iannight10412/Joint-ego-noise-reduction-source-localization-and-beamforming-for-rescue-vehicles/(list of files, cad)

Other CAD files:
models/HC-SR04 Ultrasonic Sensor Holder.ipt
models/Respeaker-holder.ipt
models/Shell-disc.ipt
