iannight10412/Joint-ego-noise-reduction-source-localization-and-beamforming-for-rescue-vehicles/docs/大學專題海報.pdf

題目

學生： | 指導教授：

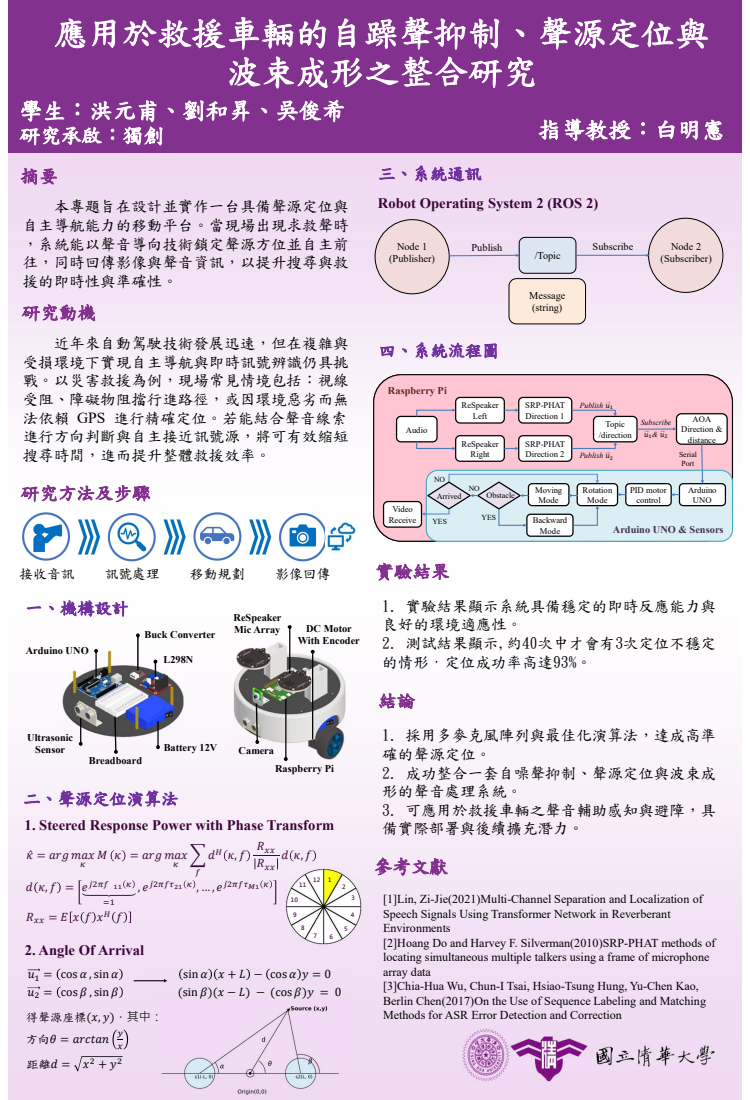
[picture p9: page 1]
研究動機; 研究方法及步驟; 實驗結果; 參考文獻; 指導教授：白明憲; 應用於救援車輛的自躁聲抑制、聲源定位與 波束成形之整合研究; 本專題旨在設計並實作一台具備聲源定位與 自主導航能力的移動平台。當現場出現求救聲時 ，系統能以聲音導向技術鎖定聲源方位並自主前 往，同時回傳影像與聲音資訊，以提升搜尋與救 援的即時性與準確性。; 一、機構設計; 四、系統流程圖; 1. 實驗結果顯示系統具備穩定的即時反應能力與 良好的環境適應性。 2. 測試結果顯示,約40次中才會有3次定位不穩定 的情形，定位成功率高達93%。; 1. 採用多麥克風陣列與最佳化演算法，達成高準 確的聲源定位。 2. 成功整合一套自噪聲抑制、聲源定位與波束成 形的聲音處理系統。 3. 可應用於救援車輛之聲音輔助感知與避障，具 備實際部署與後續擴充潛力。; Audio; ReSpeaker Left; Topic /direction; AOA Direction & distance ReSpeaker Right; SRP-PHAT Direction 1; SRP-PHAT Direction 2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

學生：洪元甫、劉和昇、吳俊希
研究承啟：獨創

三、系統通訊
Robot Operating System 2 (ROS 2)

近年來自動駕駛技術發展迅速，但在複雜與
受損環境下實現自主導航與即時訊號辨識仍具挑
戰。以災害救援為例，現場常見情境包括：視線
受阻、障礙物阻擋行進路徑，或因環境惡劣而無
法依賴 GPS 進行精確定位。若能結合聲音線索
進行方向判斷與自主接近訊號源，將可有效縮短
搜尋時間，進而提升整體救援效率。

Port PID motor

Arduino UNO & Sensors

二、聲源定位演算法
1. Steered Response Power with Phase Transform

Speech Signals Using Transformer Network in Reverberant
Environments
[2]Hoang Do and Harvey F. Silverman(2010)SRP-PHAT methods of
locating simultaneous multiple talkers using a frame of microphone
array data
[3]Chia-Hua Wu, Chun-I Tsai, Hsiao-Tsung Hung, Yu-Chen Kao,
Berlin Chen(2017)On the Use of Sequence Labeling and Matching
Methods for ASR Error Detection and Correction

[1]Lin, Zi-Jie(2021)Multi-Channel Separation and Localization of

2. Angle Of Arrival
