iannight10412/Joint-ego-noise-reduction-source-localization-and-beamforming-for-rescue-vehicles/(commit log)

2026-08-30 Create 3D print stl
2026-08-30 Create 3D print docs
2026-08-30 3D printing docs
    [HC-SR04 Ultrasonic Sensor Holder.ipt, Respeaker-holder.ipt, Shell-disc.ipt]
2026-08-30 update model
    [HC-SR04 Ultrasonic Sensor Holder.ipt, Respeaker-holder.ipt, Shell-disc.ipt]
2026-08-30 Revert "3d printing"
    [HC-SR04 Ultrasonic Sensor Holder.ipt, Respeaker-holder.ipt, Shell-disc.ipt]
